Atarity/knob-88/pics/misc.jpg

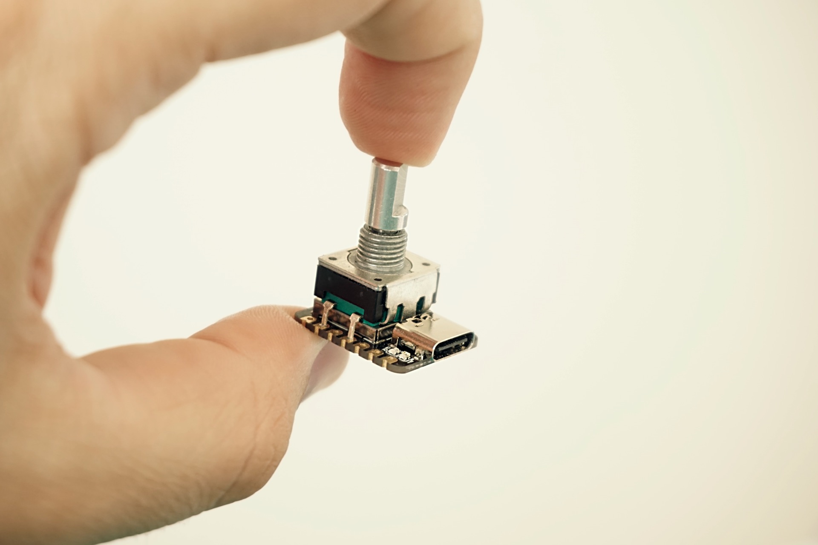
pics/misc.jpg
