Atarity/knob-88/pics/parts.jpg

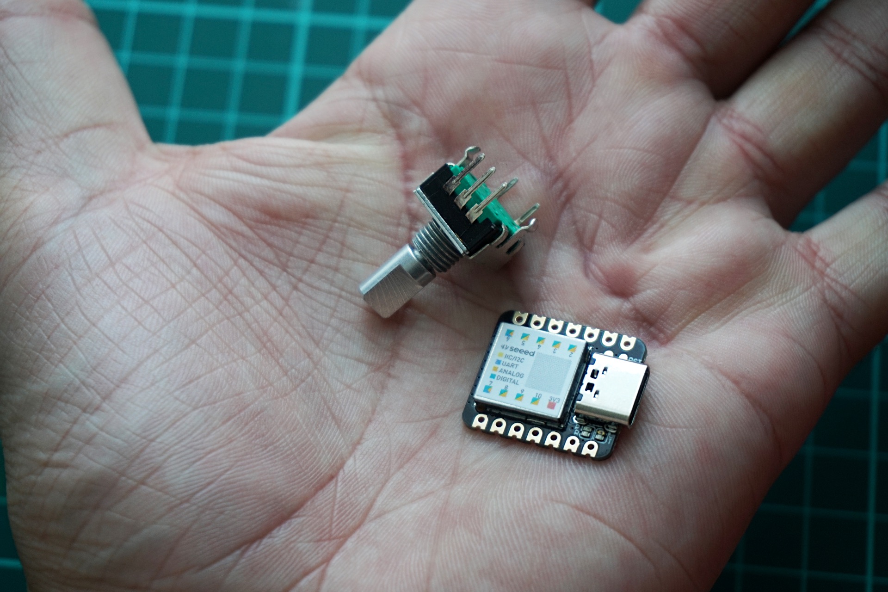
pics/parts.jpg
