Atarity/knob-88/(commit log)

2021-07-11 bit-read method does not work
    [main.cpp]
2021-07-11 working but stuck in some situations
    [main.cpp]
2021-07-12 arduino-ide with control surface lib
